onurefe/AnodePotentiostat/BOM.xls

Reference | Quantity(per board) | Quantity(total) | Value | Unit price | Link
C1 C2 | 2 | 12 | 18p | $0.10 | http://www.digikey.com/product-detail/en/samsung-electro-mechanics-america-inc/CL10C180JB8NNNC/1276-1089-1-ND/3889175
C10 C12 C14 C15 C16 C18 C20 C21 C31 C34 C39 C8 | 12 | 72 | 100n | $0.10 | http://www.digikey.com/product-detail/en/kemet/C0805C104K5RACTU/399-1170-1-ND/411445
C11 C13 C5 C57 C73 C79 C9 | 7 | 42 | 10u | $1.73 | http://www.digikey.com/product-detail/en/vishay-sprague/TR3D106K035C0135/718-1533-1-ND/1860008
C19 | 1 | 6 | 2.2u | $0.24 | http://www.digikey.com/product-detail/en/tdk-corporation/C1608X5R1E225K080AB/445-5964-1-ND/2444005
C22 C59 | 2 | 12 | 10u | $0.32 | http://www.digikey.com/product-detail/en/murata-electronics-north-america/GRM21BC8YA106KE11L/490-10504-1-ND/5026432
C27 C35 C37 C40 | 4 | 24 | 1.1n | $0.12 | http://www.digikey.com/product-detail/en/murata-electronics-north-america/GRM1885C1H112JA01D/490-1452-1-ND/587656
C3 C63 | 2 | 12 | 1u | $0.10 | http://www.digikey.com/product-detail/en/murata-electronics-north-america/GRM188R61E105KA12D/490-3897-1-ND/965939
C30 | 1 | 6 | 43p | $0.10 | http://www.digikey.com/product-detail/en/murata-electronics-north-america/GRM1885C1H430JA01D/490-1418-1-ND/587617
C32 C33 | 2 | 12 | 200p | $0.12 | http://www.digikey.com/product-detail/en/murata-electronics-north-america/GRM1885C1H201JA01D/490-1434-1-ND/587672
C36 C38 C41 | 3 | 18 | 110p | $0.12 | http://www.digikey.com/product-detail/en/murata-electronics-north-america/GRM1885C1H111JA01D/490-1428-1-ND/587649
C47 C48 | 2 | 12 | 1.6p | $0.55 | http://www.digikey.com/product-detail/en/avx-corporation/ML03511R6BAT2A/478-6713-1-ND/2694227
C46 C49 | 2 | 12 | 16p | $0.10 | http://www.digikey.com/product-detail/en/murata-electronics-north-america/GRM1885C1H160JA01D/490-1408-1-ND/587641
C45 C50 | 2 | 12 | 160p | $0.12 | http://www.digikey.com/product-detail/en/murata-electronics-north-america/GRM1885C1H161JA01D/490-1432-1-ND/587670
C25 C28 C43 C56 C86 | 5 | 30 | 10u | $0.36 | http://www.digikey.com/product-detail/en/murata-electronics-north-america/GRM188R61E106MA73D/490-7202-1-ND/3900486
C17 C23 C24 C26 C29 C42 C44 C51 C52 C53 C54 C55 C58 C6 C60 C61 C62 C64 C69 C71 C74 C75 C77 C80 C82 C84 | 26 | 156 | 100n | $0.10 | http://www.digikey.com/product-detail/en/yageo/CC0603ZRY5V9BB104/311-1343-1-ND/2103127
C65 C72 | 2 | 12 | 10n | $0.10 | http://www.digikey.com/product-detail/en/yageo/CC0603KRX7R9BB103/311-1085-1-ND/302995
C66 C68 | 2 | 12 | 6.8n | $0.18 | http://www.digikey.com/product-detail/en/murata-electronics-north-america/GRM1885C1H682JA01D/490-11477-1-ND/5333317
C67 | 1 | 6 | 3.3n | $0.10 | http://www.digikey.com/product-detail/en/murata-electronics-north-america/GRM1885C1H332JA01D/490-6385-1-ND/3845582
C70 | 1 | 6 | 47u | $1.25 | http://www.digikey.com/product-detail/en/tdk-corporation/C3216X5R1E476M160AC/445-8047-1-ND/2792164
C78 | 1 | 6 | 10u | $6.86 | http://www.digikey.com/product-detail/en/rubycon/16ST106MC44532/1189-1792-1-ND/3719908
C4 C7 C76 C81 | 4 | 24 | 4.7u | $0.32 | http://www.digikey.com/product-detail/en/murata-electronics-north-america/GRM188R6YA475KE15D/490-7205-1-ND/3900448
C83 | 1 | 6 | 33u | $8.82 | http://www.digikey.com/product-detail/en/avx-corporation/TPME336K035R0050/478-3641-1-ND/1026356
C85 | 1 | 6 | 4.7u | $6.09 | http://www.digikey.com/product-detail/en/rubycon/25ST475MC24532/1189-1808-1-ND/3719918
D1 | 1 | 6 | Diode | $0.23 | http://www.digikey.com/product-detail/en/comchip-technology/CDSF4148/641-1004-1-ND/1121126
D2 | 1 | 6 | LED Orange | $0.27 | http://www.digikey.com/product-detail/en/lite-on-inc/LTST-C191KFKT/160-1445-1-ND/386832
D3 | 1 | 6 | LED Green | $0.44 | http://www.digikey.com/product-detail/en/everlight-electronics-co-ltd/QTLP650C4TR/1080-1415-1-ND/2676149
D4 | 1 | 6 | LED Red | $0.50 | http://www.digikey.com/product-detail/en/everlight-electronics-co-ltd/QTLP650C2TR/1080-1413-1-ND/2676147
D5 | 1 | 6 | LED Yellow | $0.31 | http://www.digikey.com/product-detail/en/lite-on-inc/LTST-C191KSKT/160-1448-1-ND/386838
D6 | 1 | 6 | LED R-Y-G | $1.91 | http://www.digikey.com/product-detail/en/lumex-opto-components-inc/SSL-LX5097SISGSYC/67-2184-ND/4173024
FB1 FB2 | 2 | 12 | FILTER | $0.23 | http://www.digikey.com/product-detail/en/wurth-electronics-inc/742792093/732-1609-1-ND/1639553
JP1, JP2 | 2 | 12 | Jumper | $0.10 | http://www.digikey.com/product-detail/en/3m/969102-0000-DA/3M9580-ND/2071621
M1 | 1 | 6 | SPBTLE-RF | $11.19 | http://www.digikey.com/product-search/en/rf-if-and-rfid/rf-transceiver-modules/3539948?k=SPBTLE-RF
P3 | 1 | 6 | CONN_SWD | $0.80 | http://www.digikey.com/product-detail/en/amphenol-fci/20021121-00010C4LF/609-3695-1-ND/2209147
P4 | 1 | 6 | CONN_01X02_VIN | $0.58 | http://www.digikey.com/product-detail/en/on-shore-technology-inc/OSTVN02A150/ED10561-ND/1588862
P1, P2, P5, P6, P7 | 2 | 12 | Male headers | $0.53 | http://www.digikey.com/product-detail/en/amphenol-fci/68016-412HLF/609-3330-ND/1878493
R12 | 1 | 6 | 162K | $0.61 | http://www.digikey.com/product-detail/en/te-connectivity-passive-product/1-2176090-0/A110320CT-ND/4034675
R5 R6 R7 R14 | 4 | 24 | 1K | $0.39 | http://www.digikey.com/product-detail/en/panasonic-electronic-components/ERA-3AEB102V/P1.0KDBCT-ND/1466052
R15 R17 | 2 | 12 | 4.99K | $0.63 | http://www.digikey.com/product-detail/en/panasonic-electronic-components/ERA-3AEB4991V/P4.99KDBCT-ND/3075985
R13 R16 R18 | 3 | 18 | 1.62K | $0.63 | http://www.digikey.com/product-detail/en/panasonic-electronic-components/ERA-3AEB1621V/P1.62KDBCT-ND/3075816
R19 | 1 | 6 | 1.62M | $0.10 | http://www.digikey.com/product-detail/en/vishay-dale/CRCW06031M62FKEA/541-1.62MHCT-ND/1180174
R20 | 1 | 6 | 976R | $0.63 | http://www.digikey.com/product-detail/en/panasonic-electronic-components/ERA-3AEB9760V/P976DBCT-ND/3076092
R21 | 1 | 6 | 10.2K | $0.35 | http://www.digikey.com/product-detail/en/yageo/RT0603BRD0710K2L/YAG1502CT-ND/5138950
R22 | 1 | 6 | 15K | $11.37 | http://www.digikey.com/product-detail/en/vishay-foil-resistors-division-of-vishay-precision-group/Y163015K0000T9R/Y1630-15.0KBCT-ND/4340636
R23 | 1 | 6 | 619R | $0.63 | http://www.digikey.com/product-detail/en/panasonic-electronic-components/ERA-3AEB6190V/P619DBCT-ND/3076020
R24 | 1 | 6 | 15.8K | $0.35 | http://www.digikey.com/product-detail/en/yageo/RT0603BRD0715K8L/YAG1537CT-ND/5138985
R25 | 1 | 6 | 47R | $0.15 | http://www.digikey.com/product-detail/en/vishay-dale/CRCW060347R0JNEAHP/541-47SACT-ND/2222803
R27 | 1 | 6 | 523R | $0.35 | http://www.digikey.com/product-detail/en/yageo/RT0603BRD07523RL/YAG1684CT-ND/5139132
R28 | 1 | 6 | 19.1K | $0.35 | http://www.digikey.com/product-detail/en/yageo/RT0603BRD0719K1L/YAG1555CT-ND/5139003
R10 R11 R3 R36 R37 R4 | 6 | 36 | 2K | $0.53 | http://www.digikey.com/product-detail/en/panasonic-electronic-components/ERA-3AEB202V/P2.0KDBCT-ND/1466059
R31 R32 | 2 | 12 | 20M | $3.85 | http://www.digikey.com/product-detail/en/stackpole-electronics-inc/HVCB0603FDD20M0/HVCB0603FDD20M0CT-ND/2619792
R33 | 1 | 6 | 2M | $0.45 | http://www.digikey.com/product-detail/en/te-connectivity-passive-product/CPF0805B2M0E1/A103803CT-ND/2728842
R34 | 1 | 6 | 200K | $0.35 | http://www.digikey.com/product-detail/en/yageo/RT0603BRD07200KL/YAG1578CT-ND/5139026
R35 | 1 | 6 | 20K | $0.51 | http://www.digikey.com/product-detail/en/te-connectivity-passive-product/CPF0603B20KE1/A103062CT-ND/2728613
R40 | 1 | 6 | 1M | $0.10 | http://www.digikey.com/product-detail/en/vishay-dale/CRCW06031M00FKEA/541-1.00MHCT-ND/1180152
R2 R41 | 2 | 12 | 1K | $0.10 | http://www.digikey.com/product-detail/en/yageo/RC0603JR-071KL/311-1.0KGRCT-ND/729624
R39 R42 | 2 | 12 | 3.6M | $0.10 | http://www.digikey.com/product-detail/en/vishay-dale/CRCW06033M60FKEA/541-3.60MHCT-ND/1180214
R43 | 1 | 6 | 499K | $0.10 | http://www.digikey.com/product-detail/en/yageo/RC0603FR-07499KL/311-499KHRCT-ND/730214
R44 R45 | 2 | 12 | 20R | $0.51 | http://www.digikey.com/product-detail/en/te-connectivity-passive-product/CPF0603B20RE1/A103063CT-ND/2728614
R46 | 1 | 6 | 562K | $0.10 | http://www.digikey.com/product-detail/en/yageo/RC0603FR-07562KL/311-562KHRCT-ND/730254
R47 | 1 | 6 | 124K | $0.10 | http://www.digikey.com/product-detail/en/yageo/RC0603FR-07124KL/311-124KHRCT-ND/729872
R48 R49 | 2 | 12 | 470K | $0.10 | http://www.digikey.com/product-detail/en/yageo/RC0603JR-07470KL/311-470KGRCT-ND/729739
R50 R51 R52 R56 R57 R58 | 6 | 36 | 680R | $0.10 | http://www.digikey.com/product-detail/en/yageo/RC0603JR-07680RL/311-680GRCT-ND/729766
R1 R26 | 2 | 12 | 10K | $0.10 | http://www.digikey.com/product-detail/en/yageo/RC0603JR-0710KL/311-10KGRCT-ND/729647
R29 R30 | 2 | 12 | 10K | $0.10 | http://www.digikey.com/product-detail/en/yageo/RC0603FR-0710KL/311-10.0KHRCT-ND/729827
R53 R54 | 2 | 12 | 10K | $2.05 | http://www.digikey.com/product-detail/en/stackpole-electronics-inc/RNCF0603TKY10K0/RNCF0603TKY10K0CT-ND/2269707
R55 | 1 | 6 | 51K | $0.35 | http://www.digikey.com/product-detail/en/yageo/RT0603BRD0751KL/YAG1682CT-ND/5139130
R59 | 1 | 6 | 2.2K | $0.10 | http://www.digikey.com/product-detail/en/yageo/RC0603JR-072K2L/311-2.2KGRDKR-ND/732623
R38 R8 | 2 | 12 | 18K | $0.63 | http://www.digikey.com/product-detail/en/panasonic-electronic-components/ERA-3AEB183V/P18KDBCT-ND/1466082
R9 | 1 | 6 | 1.8K | $0.53 | http://www.digikey.com/product-detail/en/panasonic-electronic-components/ERA-3AEB182V/P1.8KDBCT-ND/1466058
RELAY1 | 1 | 6 | SIL03_1A72_71D | $3.98 | http://www.digikey.com/product-search/en?keywords=SIL03-1A72-71D
SW1 | 2 | 12 | SW_PUSH | $0.89 | http://www.digikey.com/product-detail/en/omron-electronics-inc-emc-div/B3SL-1005P/SW1203CT-ND/2627376
U10 | 1 | 6 | LMP7721 | $4.72 | http://www.digikey.com/product-detail/en/texas-instruments/LMP7721MA-NOPB/LMP7721MA-NOPB-ND/1835472
U1 U11 U7 U8 | 4 | 24 | TS5A21366 | $1.25 | http://www.digikey.com/product-detail/en/texas-instruments/TS5A21366DCUR/296-24304-1-ND/2039822
U14 | 1 | 6 | ADA4528-1 | $2.84 | http://www.digikey.com/product-detail/en/analog-devices-inc/ADA4528-1ARMZ/ADA4528-1ARMZ-ND/2616328
U15 | 1 | 6 | ADA4528-2 | $4.58 | http://www.digikey.com/product-detail/en/analog-devices-inc/ADA4528-2ARMZ-R7/ADA4528-2ARMZ-R7CT-ND/3771078
U16 | 1 | 6 | ADA4350 | $13.43 | http://www.digikey.com/product-detail/en/analog-devices-inc/ADA4350ARUZ/ADA4350ARUZ-ND/5268094
U17 | 1 | 6 | LT3062 | $3.42 | http://www.digikey.com/product-detail/en/linear-technology/LT3062EMS8E-PBF/LT3062EMS8E-PBF-ND/4964725
U18 | 1 | 6 | LTC2955-1 | $4.84 | http://www.digikey.com/product-detail/en/linear-technology/LTC2955CTS8-1-TRMPBF/LTC2955CTS8-1-TRMPBFCT-ND/3065186
U19 | 1 | 6 | LTC2378-16 | $22.13 | http://www.digikey.com/product-detail/en/linear-technology/LTC2378CMS-16-PBF/LTC2378CMS-16-PBF-ND/2749246
U2 U3 | 2 | 12 | AD5541A | $17.28 | http://www.digikey.com/product-detail/en/analog-devices-inc/AD5541ABRMZ/AD5541ABRMZ-ND/2606744
U20 | 1 | 6 | LT3042 | $4.90 | http://www.digikey.com/product-detail/en/linear-technology/LT3042EMSE-PBF/LT3042EMSE-PBF-ND/5231262
U21 | 1 | 6 | LTC6655-5 | $7.69 | http://www.digikey.com/product-detail/en/linear-technology/LTC6655CHMS8-5-PBF/LTC6655CHMS8-5-PBF-ND/2217113
U4 | 1 | 6 | OPA2836 | $3.94 | http://www.digikey.com/product-detail/en/texas-instruments/OPA2836ID/296-29793-5-ND/2770070
U12 U13 U5 U6 | 4 | 24 | AD8656 | $3.25 | http://www.digikey.com/product-detail/en/analog-devices-inc/AD8656ARMZ-REEL/AD8656ARMZ-REELCT-ND/1040872
U9 | 1 | 6 | STM32F405RGTx | $10.58 | http://www.digikey.com/product-detail/en/stmicroelectronics/STM32F405RGT6/497-11767-ND/2754208
W1 W10 W11 W12 W13 W14 W15 W2 W3 W4 W5 W6 W7 W8 W9 | 15 | 90 | TEST_1P | $0.22 | http://www.digikey.com/product-detail/en/te-connectivity-amp-connectors/RCU-0C/A106145CT-ND/3477802
Y1 | 1 | 6 | 8MHz | $0.59 | http://www.digikey.com/product-detail/en/txc-corporation/9C-8.000MEEJ-T/887-1263-1-ND/2207845
Board count | 6
Price(per board) | $251.05
Price(total) | $1506.30
