onurefe/AnodePotentiostat/Hardware/Schematic v1.0/Electrochemical Biosensor.pdf

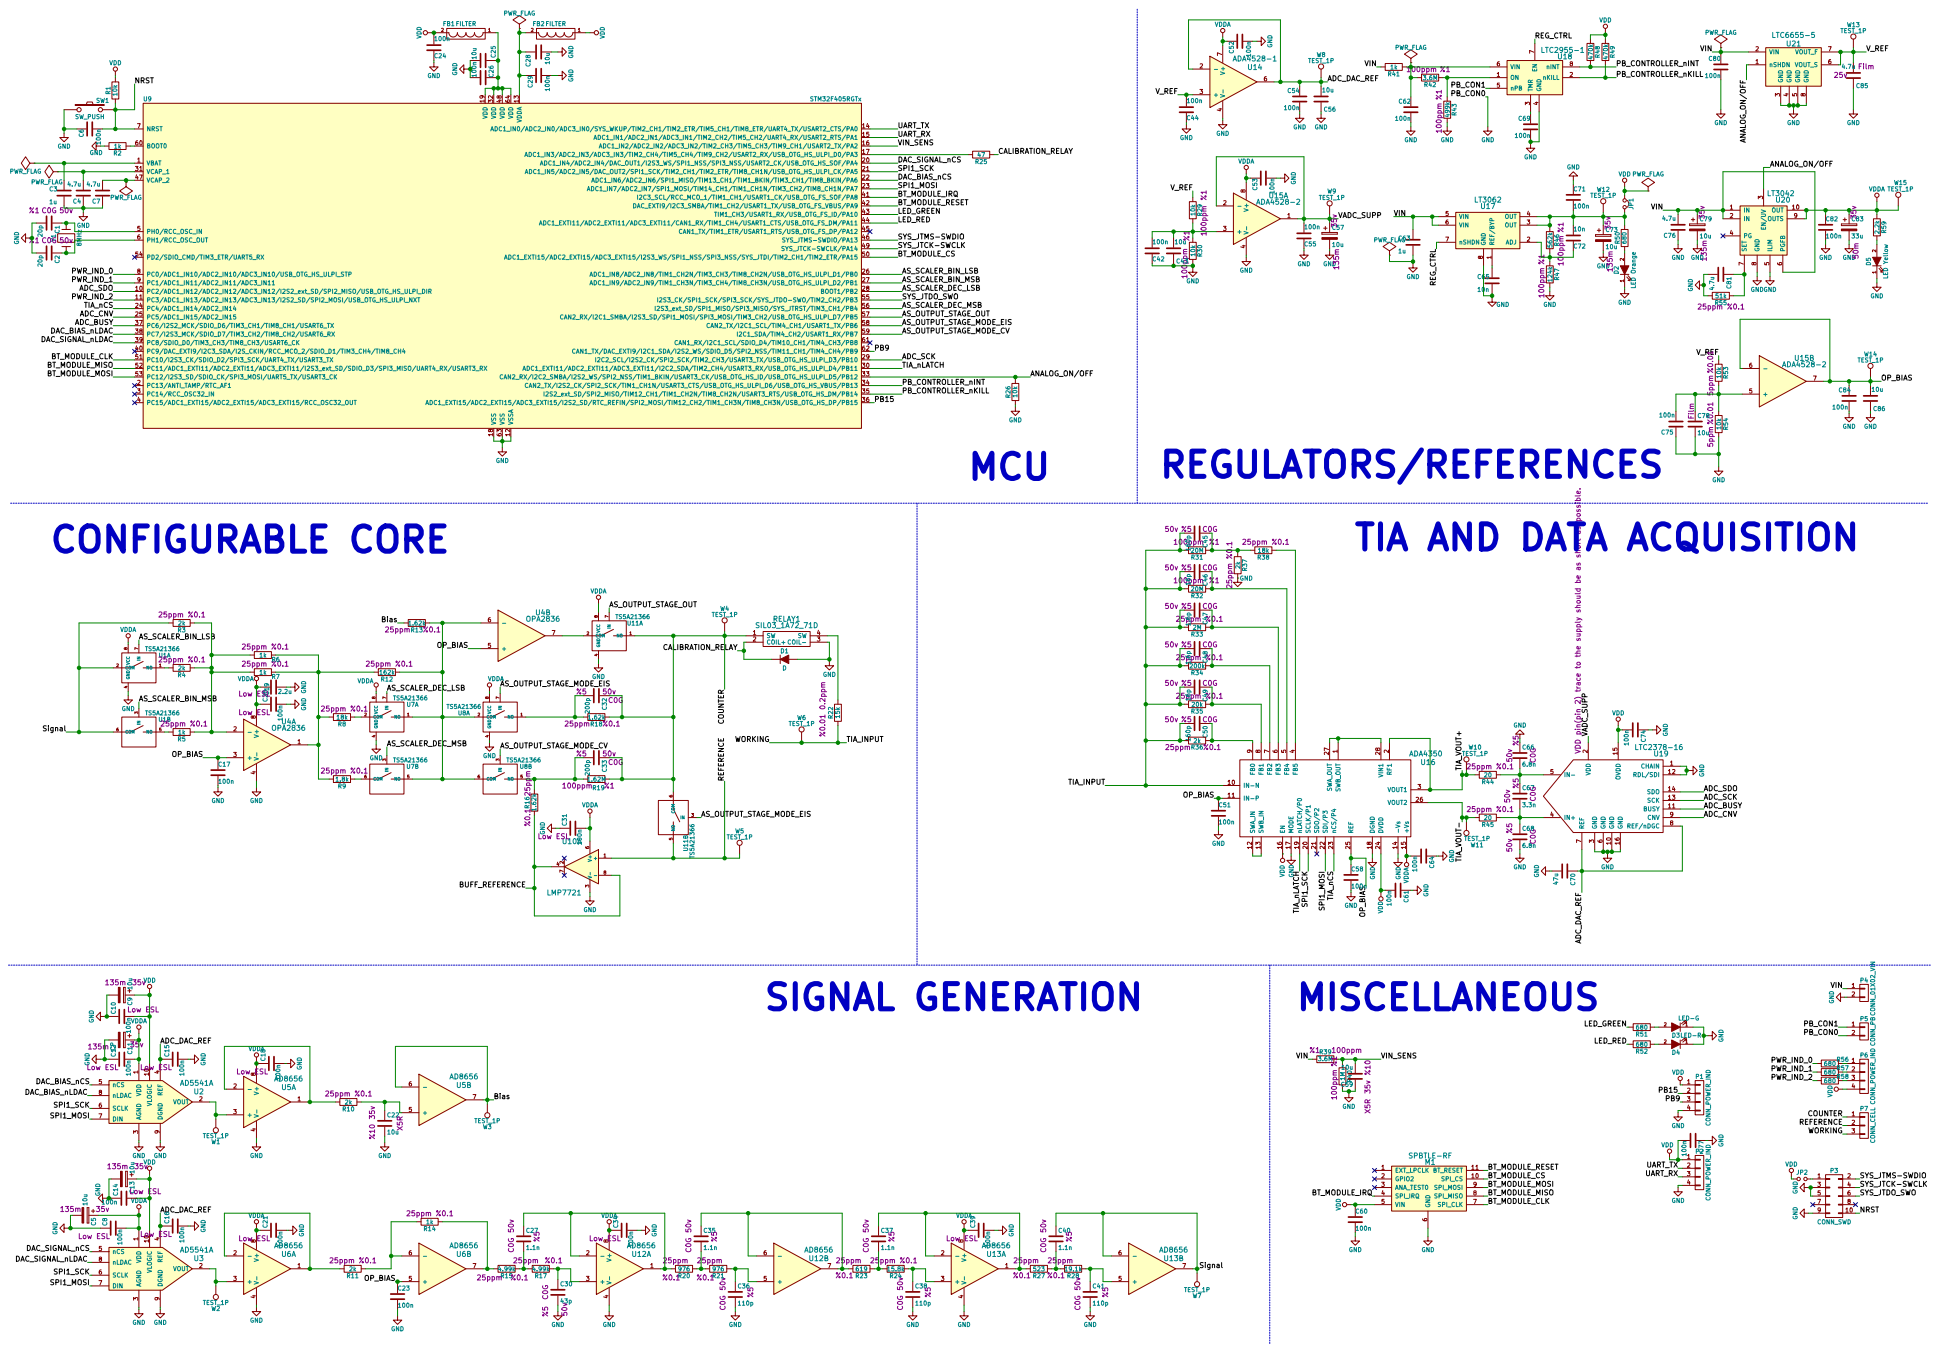
[picture p3: page 1]

GND VIN GND Bias

1 2 D5 LED Yellow GND GND GND
