onurefe/AnodePotentiostat/(list of files, drawings)

Other design files:
Hardware/Schematic v1.0/Electrochemical Biosensor.dsn
Hardware/Schematic v1.1/Electrochemical Biosensor.dsn
