onurefe/AnodePotentiostat/Hardware/Schematic v1.1/Electrochemical Biosensor.sch

## KiCad design Hardware/Schematic v1.1/Electrochemical Biosensor.sch (2018-12-31)

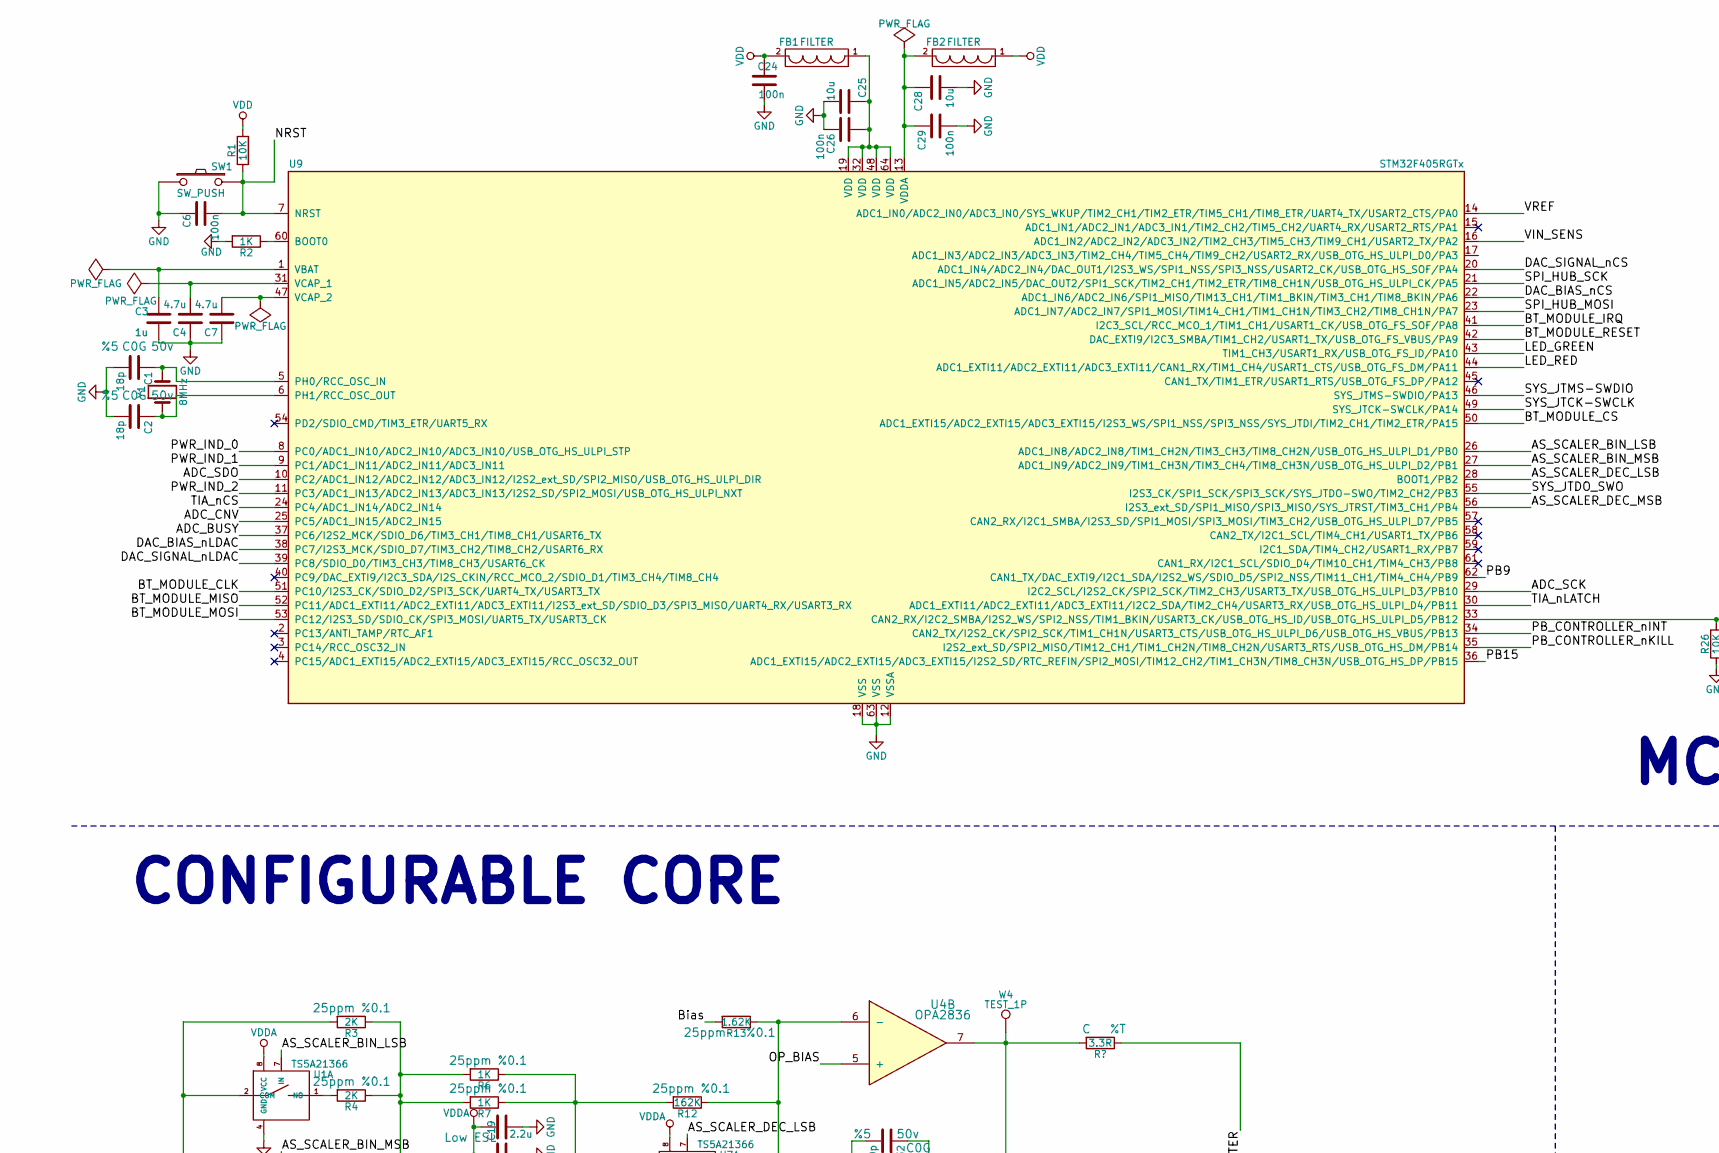
[picture p4: schematic Electrochemical Biosensor.sch, part in row 1, column 1]

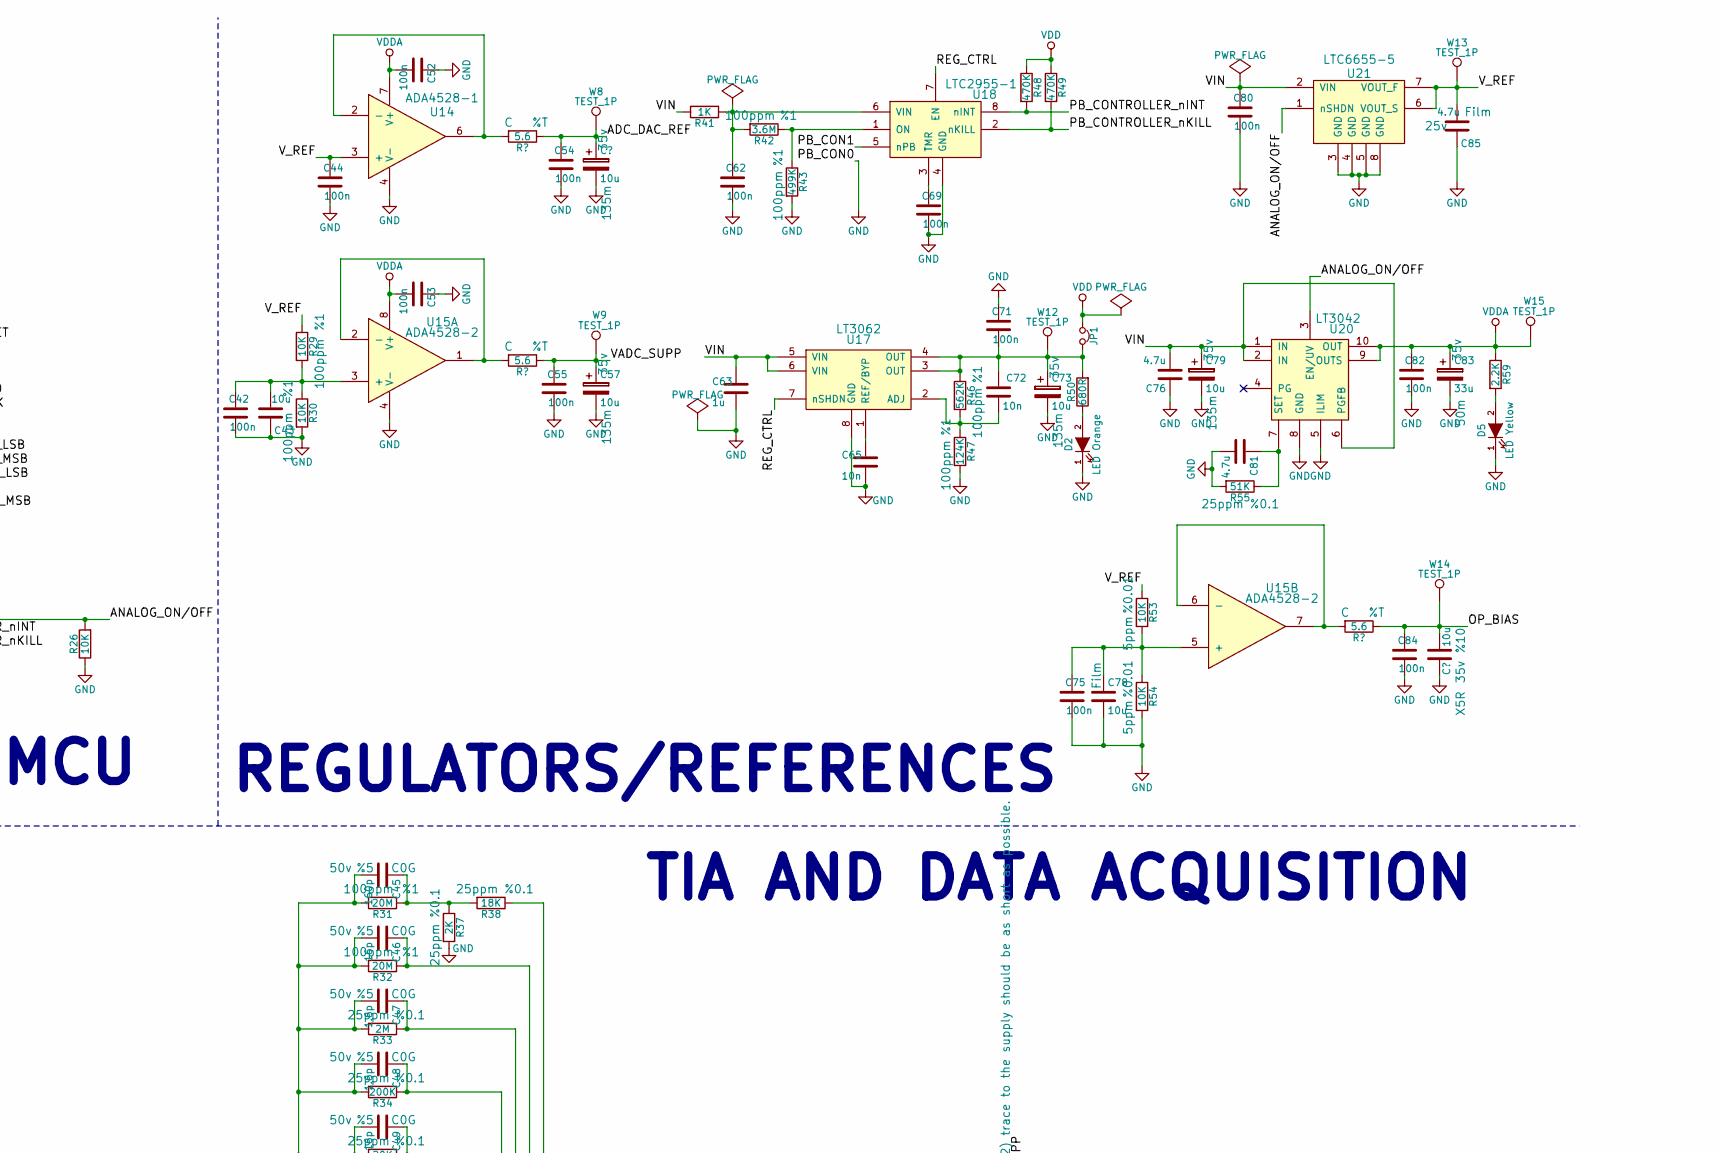
[picture p5: schematic Electrochemical Biosensor.sch, part in row 1, column 2]

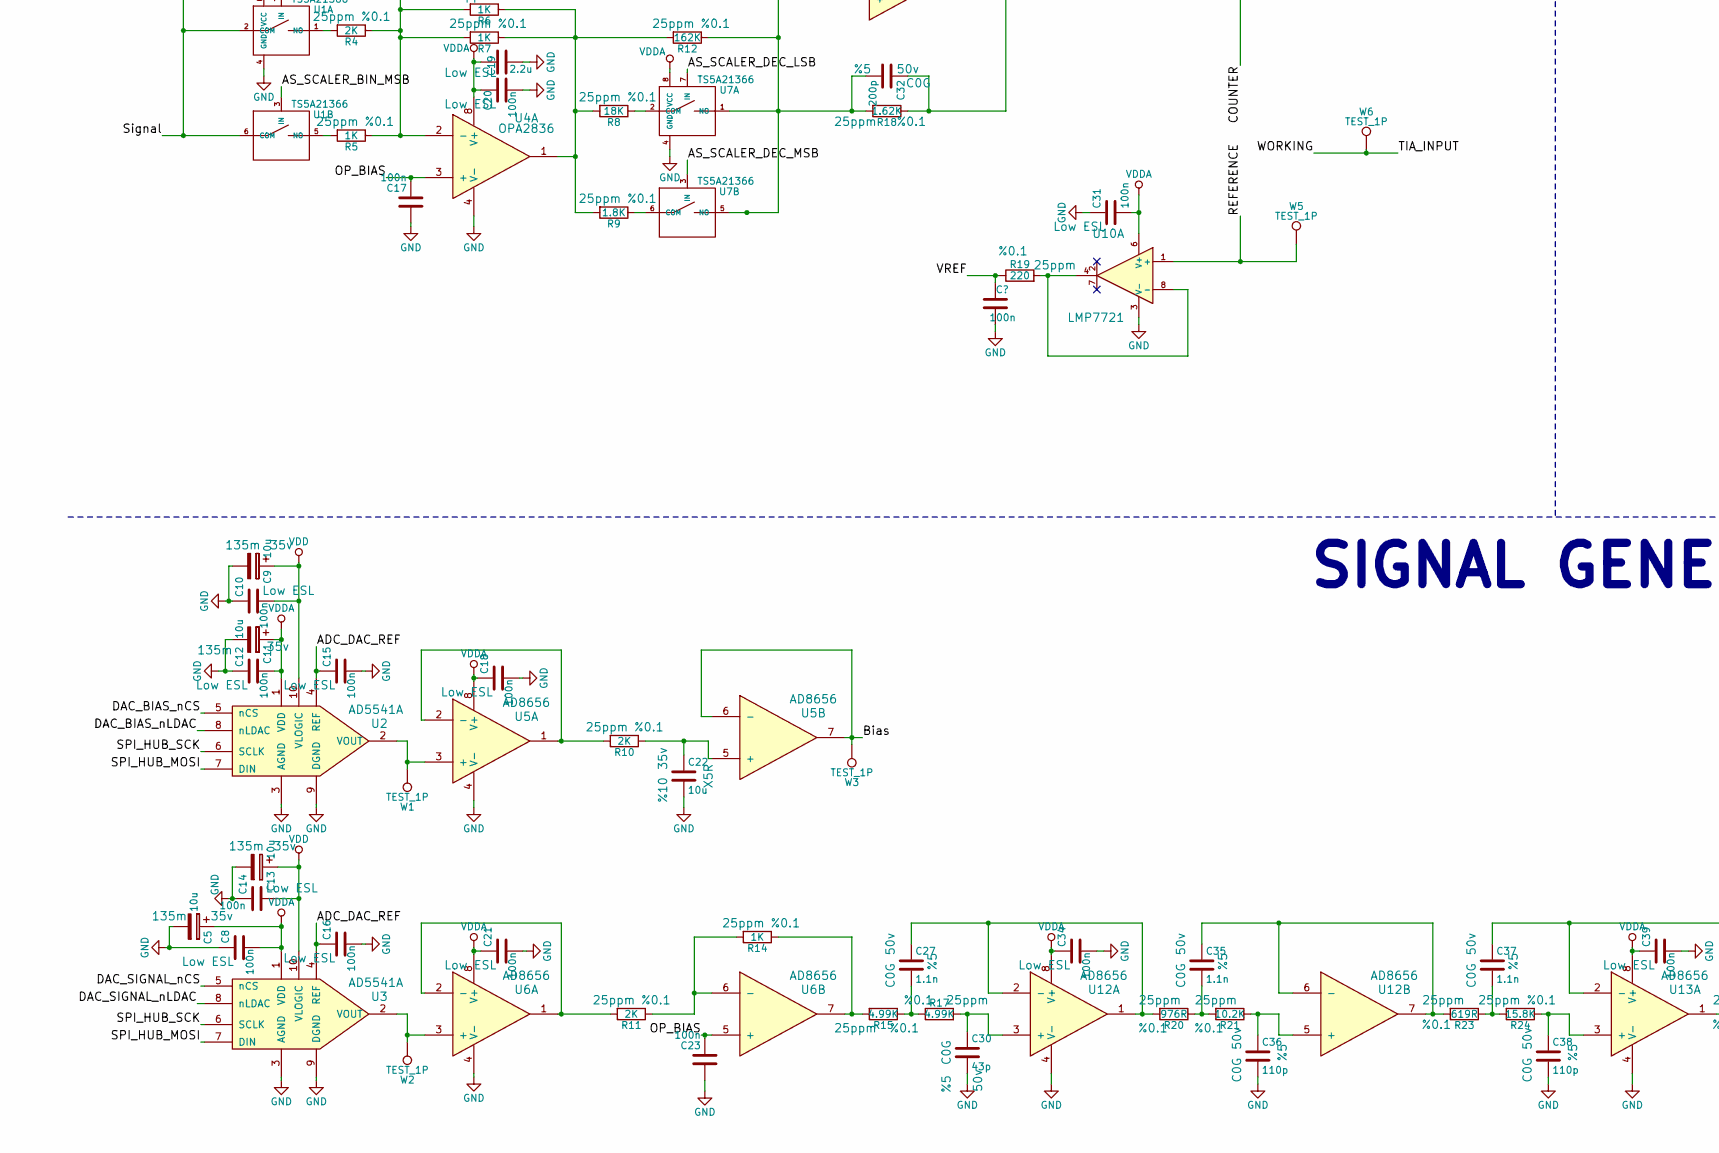
[picture p6: schematic Electrochemical Biosensor.sch, part in row 2, column 1]

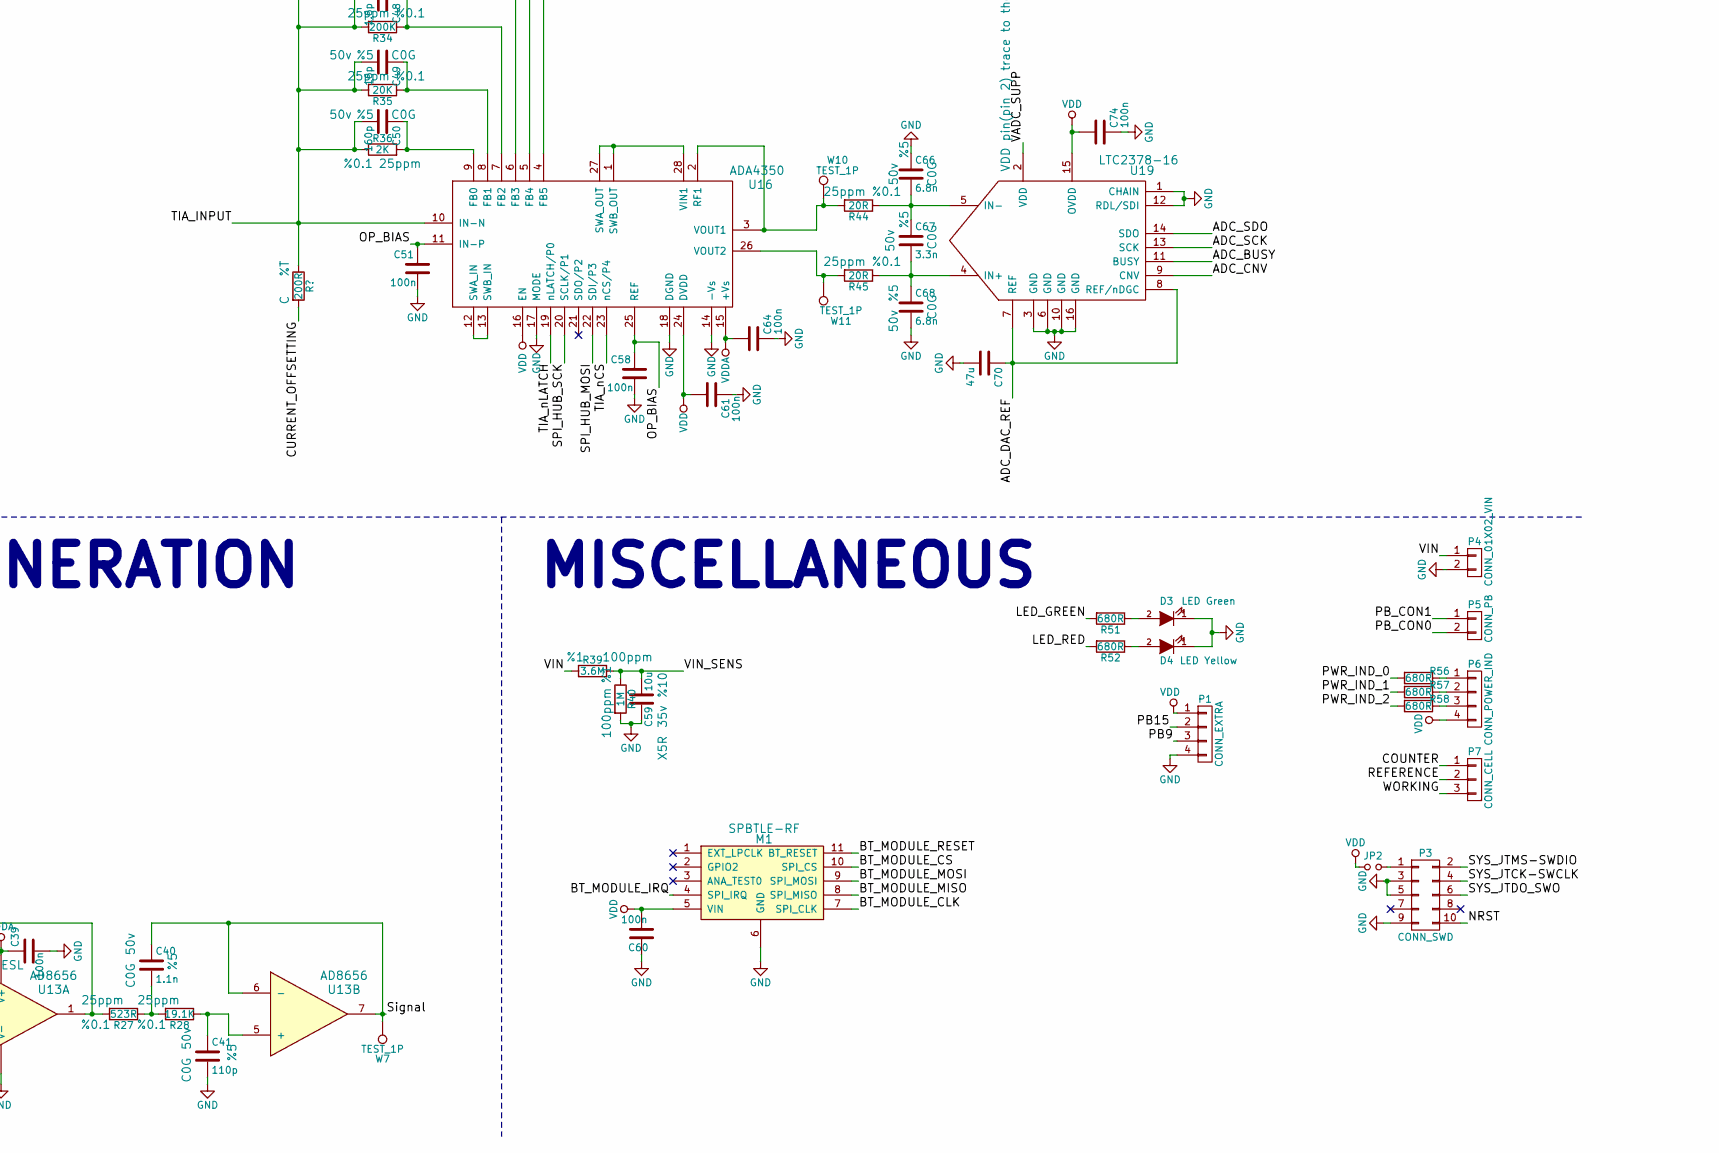
[picture p7: schematic Electrochemical Biosensor.sch, part in row 2, column 2]

Parts:
C1, C2: 18p; C_0603; Voltage 50v; Tolerance %5
C3, C63: 1u; C_0603
C4, C7, C76, C81: 4.7u; C_0603
C5, C9, C11, C13, C57, C73, C79: 10u; 2917; Voltage 35v
C6, C17, C23, C24, C26, C29, C42, C44, C51, C52, C53, C54, C55, C58, C60, C61, C62, C64, C69, C71, C74, C75, C80, C82, C84: 100n; C_0603
C8, C10, C12, C14, C15, C16, C18, C20, C21, C31, C34, C39: 100n; C_0805
C19: 2.2u; C_0603; Voltage 25v
C22, C59: 10u; C_0805; Voltage 35v; Tolerance %10
C25, C28, C43: 10u; C_0603
C27, C35, C37, C40: 1.1n; C_0603; Voltage 50v; Tolerance %5
C30: 43p; C_0603; Voltage 50v; Tolerance %5
C32: 200p; C_0603; Voltage 50v; Tolerance %5
C36, C38, C41: 110p; C_0603; Voltage 50v; Tolerance %5
C45, C50: 160p; C_0603; Voltage 50v; Tolerance %5
C46, C49: 16p; C_0603; Voltage 50v; Tolerance %5
C47, C48: 1.6p; C_0603; Voltage 50v; Tolerance %5
C65, C72: 10n; C_0603
C66, C68: 6.8n; C_0603; Voltage 50v; Tolerance %5
C67: 3.3n; C_0603; Voltage 50v; Tolerance %5
C70: 47u; C_1206
C78: 10u; C_1812
C83: 33u; 2917; Voltage 35v
C85: 4.7u; C_1812; Voltage 25v
D2: LED Orange; LED_0603
D3: LED Green; LED_1206
D4: LED Yellow; LED_1206
D5: LED Yellow; LED_0603
FB1, FB2: FILTER; R_0805
JP1: Jumper_NC_Small; Pin_Header_Straight_1x02
JP2: Jumper_NO_Small; Pin_Header_Straight_1x02
M1: SPBTLE-RF
P1: CONN_EXTRA; Pin_Header_Straight_1x04
P3: CONN_SWD; Pin_Header_Straight_2x05_Pitch1.27mm
P4: CONN_01X02_VIN; TerminalBlock_Pheonix_MPT-2.54mm_2pol
P5: CONN_PB; Pin_Header_Straight_1x02
P6: CONN_POWER_IND; Pin_Header_Straight_1x04
P7: CONN_CELL; Pin_Header_Straight_1x03
R1, R26: 10K; R_0603
R2, R41: 1K; R_0603
R3, R4, R10, R11, R36, R37: 2K; R_0603; Tolerance %0.1
R5, R6, R7, R14: 1K; R_0603; Tolerance %0.1
R8, R38: 18K; R_0603; Tolerance %0.1
R9: 1.8K; R_0603; Tolerance %0.1
R12: 162K; R_0603; Tolerance %0.1
R13, R18: 1.62K; R_0603; Tolerance %0.1
R15, R17: 4.99K; R_0603; Tolerance %0.1
R19: 220; R_0603; Tolerance %0.1
R20: 976R; R_0603; Tolerance %0.1
R21: 10.2K; R_0603; Tolerance %0.1
R23: 619R; R_0603; Tolerance %0.1
R24: 15.8K; R_0603; Tolerance %0.1
R27: 523R; R_0603; Tolerance %0.1
R28: 19.1K; R_0603; Tolerance %0.1
R29, R30: 10K; R_0603; Tolerance %1
R31, R32: 20M; R_0603; Tolerance %1
R33: 2M; R_0805; Tolerance %0.1
R34: 200K; R_0603; Tolerance %0.1
R35: 20K; R_0603; Tolerance %0.1
R39, R42: 3.6M; R_0603; Tolerance %1
R40: 1M; R_0603; Tolerance %1
R43: 499K; R_0603; Tolerance %1
R44, R45: 20R; R_0603; Tolerance %0.1
R46: 562K; R_0603; Tolerance %1
R47: 124K; R_0603; Tolerance %1
R48, R49: 470K; R_0603
R50, R51, R52, R56, R57, R58: 680R; R_0603
R53, R54: 10K; R_0603; Tolerance %0.01
R55: 51K; R_0603; Tolerance %0.1
R59: 2.2K; R_0603
SW1: SW_PUSH; SW_SPST_B3S-1005
U1, U7: TS5A21366; VSSOP-DCU
U2, U3: AD5541A; MSOP-10_3x3mm_Pitch0.5mm
U4: OPA2836; SOIC-8_3.9x4.9mm_Pitch1.27mm
U5, U6, U12, U13: AD8656; MSOP-8_3x3mm_Pitch0.65mm
U9: STM32F405RGTx; LQFP-64_10x10mm_Pitch0.5mm
U10: LMP7721; SOIC-8_3.9x4.9mm_Pitch1.27mm
U14: ADA4528-1; MSOP-8_3x3mm_Pitch0.65mm
U15: ADA4528-2; MSOP-8_3x3mm_Pitch0.65mm
U16: ADA4350; TSSOP-28_4.4x9.7mm_Pitch0.65mm
U17: LT3062; MSOP-10-1EP_3x3mm_Pitch0.5mm
U18: LTC2955-1; TSOT-23-8
U19: LTC2378-16; MSOP-16_3x4mm_Pitch0.5mm
U20: LT3042; MSOP-10-1EP_3x3mm_Pitch0.5mm
U21: LTC6655-5; MSOP-8_3x3mm_Pitch0.65mm
W1, W2, W3, W4, W5, W6, W7, W8, W9, W10, W11, W12, W13, W14, W15: TEST_1P; Measurement_Point_Round-SMD-Pad_Small
Y1: 8MHz; Crystal_HC49-SD_SMD; Tolerance 10ppm

Connections:
ADC_BUSY: U9.37 (PC6/I2S2_MCK/SDIO_D6/TIM3_CH1/TIM8_CH1/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), U19.11 (BUSY)
ADC_CNV: U9.25 (PC5/ADC1_IN15/ADC2_IN15), U19.9 (CNV)
ADC_DAC_REF: C15.1, C16.1, C54.1, C70.1, U2.4 (REF), U3.4 (REF), U19.7 (REF), U19.8 (REF/nDGC), W8.1
ADC_SCK: U9.29 (I2C2_SCL/I2S2_CK/SPI2_SCK/TIM2_CH3/USAR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), U19.13 (SCK)
ADC_SDO: U9.10 (PC2/ADC1_IN12/ADC2_IN12/ADC3_IN12/I2S2_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), U19.14 (SDO)
ANALOG_ON/OFF: R26.2, U9.33 (CAN2_RX/I2C2_SMBA/I2S2_WS/SPI2_NSS/TIM1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), U20.3 (EN/UV), U21.1 (nSHDN)
AS_SCALER_BIN_LSB: U1.7 (IN), U9.26 (ADC1_IN8/ADC2_IN8/TIM1_CH2N/TIM3_CH3/TI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)
AS_SCALER_BIN_MSB: U1.3 (IN), U9.27 (ADC1_IN9/ADC2_IN9/TIM1_CH3N/TIM3_CH4/TI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)
AS_SCALER_DEC_LSB: U7.7 (IN), U9.28 (BOOT1/PB2)
AS_SCALER_DEC_MSB: U7.3 (IN), U9.56 (I2S3_ext_SD/SPI1_MISO/SPI3_MISO/SYS_JTR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)
BT_MODULE_CLK: M1.7 (SPI_CLK), U9.51 (PC10/I2S3_CK/SDIO_D2/SPI3_SCK/UART4_TX/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)
BT_MODULE_CS: M1.10 (SPI_CS), U9.50 (ADC1_EXTI15/ADC2_EXTI15/ADC3_EXTI15/I2S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)
BT_MODULE_IRQ: M1.4 (SPI_IRQ), U9.41 (I2C3_SCL/RCC_MCO_1/TIM1_CH1/USART1_CK/U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)
BT_MODULE_MISO: M1.8 (SPI_MISO), U9.52 (PC11/ADC1_EXTI11/ADC2_EXTI11/ADC3_EXTI1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)
BT_MODULE_MOSI: M1.9 (SPI_MOSI), U9.53 (PC12/I2S3_SD/SDIO_CK/SPI3_MOSI/UART5_TX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)
BT_MODULE_RESET: M1.11 (BT_RESET), U9.42 (DAC_EXTI9/I2C3_SMBA/TIM1_CH2/USART1_TX/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)
Bias: R13.2, U5.6 (-), U5.7, W3.1
COUNTER: P7.1
DAC_BIAS_nCS: U2.5 (nCS), U9.22 (ADC1_IN6/ADC2_IN6/SPI1_MISO/TIM13_CH1/T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)
DAC_BIAS_nLDAC: U2.8 (nLDAC), U9.38 (PC7/I2S3_MCK/SDIO_D7/TIM3_CH2/TIM8_CH2/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)
DAC_SIGNAL_nCS: U3.5 (nCS), U9.20 (ADC1_IN4/ADC2_IN4/DAC_OUT1/I2S3_WS/SPI1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)
DAC_SIGNAL_nLDAC: U3.8 (nLDAC), U9.39 (PC8/SDIO_D0/TIM3_CH3/TIM8_CH3/USART6_CK)
GND: C1.2, C2.2, C3.2, C4.1, C5.2, C6.1, C7.1, C8.1, C9.2, C10.1, C11.2, C12.1, C13.2, C14.1, C15.2, C16.2, C17.2, C18.2, C19.1, C20.2, C21.2, C22.2, C23.2, C24.2, C25.2, C26.1, C28.2, C29.2, C30.2, C31.1, C34.2, C36.2, C38.2, C39.2, C41.2, C42.2, C43.1, C44.2, C51.1, C52.1, C53.1, C54.2, C55.2, C57.2, C58.1, C59.1, C60.1, C61.1, C62.2, C63.2, C64.1, C65.2, C66.1, C68.2, C69.2, C70.2, C71.1, C73.2, C74.1, C75.2, C76.1, C78.2, C79.2, C80.2, C81.2, C82.2, C83.2, C84.2, C85.1, D2.1 (K), D3.1 (K), D4.1 (K), D5.1 (K), M1.6 (GND), P1.4, P3.3, P3.5, P3.9, P4.2, P5.2, R2.2, R26.1, R30.2, R37.2, R40.2, R43.2, R47.2, R54.2, R55.2, SW1.1, U1.4 (GND), U2.3 (AGND), U2.9 (DGND), U3.3 (AGND), U3.9 (DGND), U4.4 (V-), U5.4 (V-), U6.4 (V-), U7.4 (GND), U9.12 (VSSA), U9.18 (VSS), U9.63 (VSS), U10.3 (V-), U12.4 (V-), U13.4 (V-), U14.4 (V-), U15.4 (V-), U16.14 (-Vs), U16.17 (MODE), U16.18 (DGND), U17.8 (GND), U18.4 (GND), U19.1 (CHAIN), U19.3 (GND), U19.6 (GND), U19.10 (GND), U19.12 (RDL/SDI), U19.16 (GND), U20.5 (ILIM), U20.8 (GND), U21.3 (GND), U21.4 (GND), U21.5 (GND), U21.8 (GND)
LED_GREEN: R51.2, U9.43 (TIM1_CH3/USART1_RX/USB_OTG_FS_ID/PA10)
LED_RED: R52.2, U9.44 (ADC1_EXTI11/ADC2_EXTI11/ADC3_EXTI11/CAN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)
NRST: C6.2, P3.10, R1.1, SW1.2, U9.7 (NRST)
unnamed: C1.1, U9.5 (PH0/RCC_OSC_IN), Y1.2
unnamed: C2.1, U9.6 (PH1/RCC_OSC_OUT), Y1.1
unnamed: C3.1, U9.1 (VBAT)
unnamed: C4.2, U9.31 (VCAP_1)
unnamed: C7.2, U9.47 (VCAP_2)
unnamed: C22.1, R10.1, U5.5 (+)
unnamed: C25.1, C26.2, FB1.1, U9.19 (VDD), U9.32 (VDD), U9.48 (VDD), U9.64 (VDD)
unnamed: C27.1, R20.2, U12.1, U12.2 (-)
unnamed: C27.2, R15.1, R17.1
unnamed: C28.1, C29.1, FB2.2, U9.13 (VDDA)
unnamed: C30.1, R17.2, U12.3 (+)
unnamed: C32.1, R18.1, U4.7, W4.1
unnamed: C32.2, R12.1, R13.1, R18.2, U4.6 (-), U7.1 (NO), U7.5 (NO)
unnamed: C35.1, R23.2, U12.6 (-), U12.7
unnamed: C35.2, R20.1, R21.2
unnamed: C36.1, R21.1, U12.5 (+)
unnamed: C37.1, R27.2, U13.1, U13.2 (-)
unnamed: C37.2, R23.1, R24.2
unnamed: C38.1, R24.1, U13.3 (+)
unnamed: C40.2, R27.1, R28.2
unnamed: C41.1, R28.1, U13.5 (+)
unnamed: C42.1, C43.2, R29.2, R30.1, U15.3 (+)
unnamed: C45.1, R31.1, R37.1, R38.2
unnamed: C46.1, R32.1, U16.5 (FB4)
unnamed: C47.1, R33.1, U16.6 (FB3)
unnamed: C48.1, R34.1, U16.7 (FB2)
unnamed: C49.1, R35.1, U16.8 (FB1)
unnamed: C50.1, R36.2, U16.9 (FB0)
unnamed: C62.1, R41.1, R42.2, U18.6 (VIN)
unnamed: C65.1, U17.1 (REF/BYP)
unnamed: C66.2, C67.1, R44.1, U19.5 (IN-)
unnamed: C67.2, C68.1, R45.1, U19.4 (IN+)
unnamed: C69.1, U18.3 (TMR)
unnamed: C71.2, C72.1, C73.1, JP1.2, R46.1, R50.2, U17.3 (OUT), U17.4 (OUT), W12.1
unnamed: C72.2, R46.2, R47.1, U17.2 (ADJ)
unnamed: C75.1, C78.1, R53.2, R54.1, U15.5 (+)
unnamed: C81.1, R55.1, U20.7 (SET)
unnamed: D2.2 (A), R50.1
unnamed: D3.2 (A), R51.1
unnamed: D4.2 (A), R52.1
unnamed: D5.2 (A), R59.2
unnamed: JP2.2, P3.1
unnamed: P6.1, R56.1
unnamed: P6.2, R57.1
unnamed: P6.3, R58.1
unnamed: R2.1, U9.60 (BOOT0)
unnamed: R3.1, R4.1, R5.1, R6.2, R7.2, U4.2 (-)
unnamed: R4.2, U1.1 (NO)
unnamed: R5.2, U1.5 (NO)
unnamed: R8.1, U7.2 (COM)
unnamed: R9.1, U7.6 (COM)
unnamed: R10.2, U5.1, U5.2 (-)
unnamed: R11.1, R14.2, U6.6 (-)
unnamed: R11.2, U6.1, U6.2 (-)
unnamed: R6.1, R7.1, R8.2, R9.2, R12.2, U4.1
unnamed: R14.1, R15.2, U6.7
unnamed: R19.2, U10.4, U10.8 (-)
unnamed: R38.1, U16.4 (FB5)
unnamed: R42.1, R43.1, U18.1 (ON)
unnamed: R44.2, U16.2 (RF1), U16.3 (VOUT1), W10.1
unnamed: R45.2, U16.26 (VOUT2), W11.1
unnamed: U2.2 (VOUT), U5.3 (+), W1.1
unnamed: U3.2 (VOUT), U6.3 (+), W2.1
unnamed: U14.2 (-), U14.6
unnamed: U15.1, U15.2 (-)
unnamed: U15.6 (-), U15.7
unnamed: U16.1 (SWB_OUT), U16.27 (SWA_OUT), U16.28 (VIN1)
unnamed: U16.12 (SWA_IN), U16.13 (SWB_IN)
OP_BIAS: C17.1, C23.1, C51.2, C58.2, C84.1, U4.3 (+), U4.5 (+), U6.5 (+), U16.11 (IN-P), U16.25 (REF), W14.1
PB9: P1.3, U9.62 (CAN1_TX/DAC_EXTI9/I2C1_SDA/I2S2_WS/SDIO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)
PB15: P1.2, U9.36 (ADC1_EXTI15/ADC2_EXTI15/ADC3_EXTI15/I2S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)
PB_CON1: P5.1, U18.5 (nPB)
PB_CONTROLLER_nINT: R48.2, U9.34 (CAN2_TX/I2S2_CK/SPI2_SCK/TIM1_CH1N/USAR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), U18.8 (nINT)
PB_CONTROLLER_nKILL: R49.2, U9.35 (I2S2_ext_SD/SPI2_MISO/TIM12_CH1/TIM1_CH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), U18.2 (nKILL)
PWR_IND_0: R56.2, U9.8 (PC0/ADC1_IN10/ADC2_IN10/ADC3_IN10/USB_O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)
PWR_IND_1: R57.2, U9.9 (PC1/ADC1_IN11/ADC2_IN11/ADC3_IN11)
PWR_IND_2: R58.2, U9.11 (PC3/ADC1_IN13/ADC2_IN13/ADC3_IN13/I2S2_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)
REFERENCE: P7.2, U10.1 (+), W5.1
REG_CTRL: U17.7 (nSHDN), U18.7 (EN)
SPI_HUB_MOSI: U2.7 (DIN), U3.7 (DIN), U9.23 (ADC1_IN7/ADC2_IN7/SPI1_MOSI/TIM14_CH1/T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), U16.22 (SDI/P3)
SPI_HUB_SCK: U2.6 (SCLK), U3.6 (SCLK), U9.21 (ADC1_IN5/ADC2_IN5/DAC_OUT2/SPI1_SCK/TIM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), U16.20 (SCLK/P1)
SYS_JTCK-SWCLK: P3.4, U9.49 (SYS_JTCK-SWCLK/PA14)
SYS_JTDO_SWO: P3.6, U9.55 (I2S3_CK/SPI1_SCK/SPI3_SCK/SYS_JTDO-SWO/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)
SYS_JTMS-SWDIO: P3.2, U9.46 (SYS_JTMS-SWDIO/PA13)
Signal: C40.1, R3.2, U1.2 (COM), U1.6 (COM), U13.6 (-), U13.7, W7.1
TIA_INPUT: C45.2, C46.2, C47.2, C48.2, C49.2, C50.2, P7.3, R31.2, R32.2, R33.2, R34.2, R35.2, R36.1, U16.10 (IN-N), W6.1
TIA_nCS: U9.24 (PC4/ADC1_IN14/ADC2_IN14), U16.23 (nCS/P4)
TIA_nLATCH: U9.30 (ADC1_EXTI11/ADC2_EXTI11/ADC3_EXTI11/I2C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), U16.19 (nLATCH/P0)
VADC_SUPP: C55.1, C57.1, U19.2 (VDD), W9.1
VDD: C9.1, C10.2, C13.1, C14.2, C24.1, C60.2, C61.2, C74.2, FB1.2, FB2.1, JP1.1, JP2.1, M1.5 (VIN), P1.1, P6.4, R1.2, R48.1, R49.1, U2.10 (VLOGIC), U3.10 (VLOGIC), U16.16 (EN), U16.24 (DVDD), U19.15 (OVDD)
VDDA: C5.1, C8.2, C11.1, C12.2, C18.1, C19.2, C20.1, C21.1, C31.2, C34.1, C39.1, C52.2, C53.2, C64.2, C82.1, C83.1, R59.1, U1.8 (VCC), U2.1 (VDD), U3.1 (VDD), U4.8 (V+), U5.8 (V+), U6.8 (V+), U7.8 (VCC), U10.6 (V+), U12.8 (V+), U13.8 (V+), U14.7 (V+), U15.8 (V+), U16.15 (+Vs), U20.9 (OUTS), U20.10 (OUT), W15.1
VIN: C63.1, C76.2, C79.1, C80.1, P4.1, R39.1, R41.2, U17.5 (VIN), U17.6 (VIN), U20.1 (IN), U20.2 (IN), U20.6 (PGFB), U21.2 (VIN)
VIN_SENS: C59.2, R39.2, R40.1, U9.16 (ADC1_IN2/ADC2_IN2/ADC3_IN2/TIM2_CH3/TIM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)
VREF: R19.1, U9.14 (ADC1_IN0/ADC2_IN0/ADC3_IN0/SYS_WKUP/TIM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)
V_REF: C44.1, C85.2, R29.1, R53.1, U14.3 (+), U21.6 (VOUT_S), U21.7 (VOUT_F), W13.1

Notes on the sheet:
SIGNAL GENERATION
TIA AND DATA ACQUISITION
CONFIGURABLE CORE
REGULATORS/REFERENCES
MCU
MISCELLANEOUS
