onurefe/AnodePotentiostat/Firmware/Include/sensor_service.h

/**
  ******************************************************************************
  * @file    sensor_service.h 
  * @author  CL
  * @version V1.0.0
  * @date    04-July-2014
  * @brief   
  ******************************************************************************
  * @attention
  *
  * <h2><center>&copy; COPYRIGHT(c) 2014 STMicroelectronics</center></h2>
  *
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
  ******************************************************************************
  */
  
/* Define to prevent recursive inclusion -------------------------------------*/  
#ifndef _SENSOR_SERVICE_H_
#define _SENSOR_SERVICE_H_

#ifdef __cplusplus
 extern "C" {
#endif 

/* Includes ------------------------------------------------------------------*/
#include "hal_types.h"
#include "bluenrg_gatt_server.h"
#include "bluenrg_gap.h"
#include "string.h"
#include "bluenrg_gap_aci.h"
#include "bluenrg_gatt_aci.h"
#include "hci_const.h"
#include "gp_timer.h"
#include "bluenrg_hal_aci.h"
#include "bluenrg_aci_const.h"   
#include "hci.h"
#include "hci_le.h"
#include "hal.h"
#include "sm.h"
#include "debug.h"

#include <stdlib.h>

/** @addtogroup X-CUBE-BLE1_Applications
 *  @{
 */

/** @addtogroup SensorDemo
 *  @{
 */
 
/** @addtogroup SENSOR_SERVICE 
 * @{
 */

/** @addtogroup SENSOR_SERVICE_Exported_Defines 
 * @{
 */
/* Exported defines ----------------------------------------------------------*/   
#define IDB04A1 0
#define IDB05A1 1

/**
 * @brief Instantiate two new services:
 *        1. Timer Service with two characteristics
 *           - Seconds characteristic (Readable only)
 *           - Minutes characteristics (Readable and Notifiable)
 *        2. LED Button Service with one characteristic
 *           - LED characteristic (Readable and Writable)
 */
#define NEW_SERVICES 0
/**
 * @}
 */

/** @addtogroup SENSOR_SERVICE_Exported_Types
 *  @{
 */
typedef int i32_t;

/** 
 * @brief Structure containing acceleration value (in mg) of each axis.
 */
typedef struct {
  i32_t AXIS_X;
  i32_t AXIS_Y;
  i32_t AXIS_Z;
} AxesRaw_t;
/**
 * @}
 */

/** @addtogroup SENSOR_SERVICE_Exported_Functions
 *  @{
 */
tBleStatus Add_Acc_Service(void);
tBleStatus Acc_Update(AxesRaw_t *data);
tBleStatus Add_Environmental_Sensor_Service(void);
void       setConnectable(void);
void       enableNotification(void);
void       GAP_ConnectionComplete_CB(uint8_t addr[6], uint16_t handle);
void       GAP_DisconnectionComplete_CB(void);
void       HCI_Event_CB(void *pckt);

#if NEW_SERVICES
  tBleStatus Add_Time_Service(void);
  tBleStatus Seconds_Update(void);
  tBleStatus Minutes_Notify(void);
  void       Update_Time_Characteristics(void);

  tBleStatus Add_LED_Service(void);
  void       Attribute_Modified_CB(uint16_t handle, uint8_t data_length,
                                   uint8_t *att_data);
#endif
/**
 * @}
 */

/**
 * @}
 */
 
/**
 * @}
 */

/**
 * @}
 */

#ifdef __cplusplus
}
#endif

#endif /* _SENSOR_SERVICE_H_ */

/************************ (C) COPYRIGHT STMicroelectronics *****END OF FILE****/
