onurefe/AnodePotentiostat/(commit log)

2018-12-31 Added firmwares, documents and software.
    [BOM.csv, BOM.xls, Electrochemical Biosensor.dsn, Electrochemical Biosensor.sch, Group Delay.csv, Magnitude(Volts per Volt).csv, Magnitude(dB).csv, Noise.csv]
2020-09-02 v1.1 related work started.
    [BOM.csv, BOM.xls, Electrochemical Biosensor.dsn, Electrochemical Biosensor.sch, Group Delay.csv, Magnitude(Volts per Volt).csv, Magnitude(dB).csv, Noise.csv]
