onurefe/AnodePotentiostat/(notices)

Notices in the files:
Firmware/Source/eeprom_emulator.c:
under the terms of the GNU General Public License as published by the Free
